arturvc/ROOK/ROOK_CAD/README.md

### ROOK
#### PLAYFUL DATA VISUALIZATION FOR AIR QUALITY

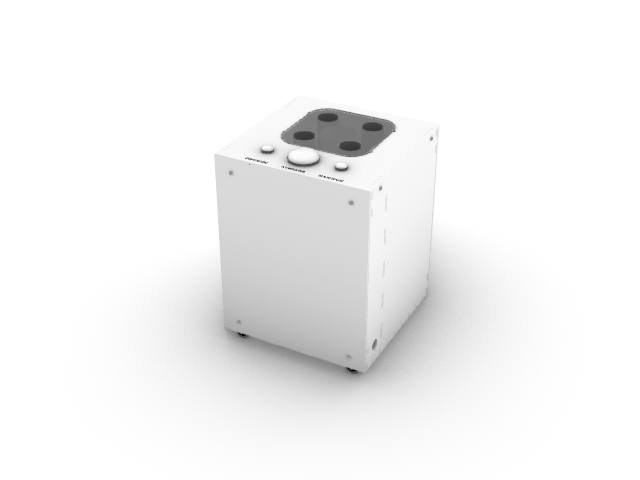
[picture p2: ROOK_CAD/Rook.png]
Rook


CAD file with the design of Rook, for laser cutting plywood with 8mm thickness and clear acrylic with 2mm thickness.

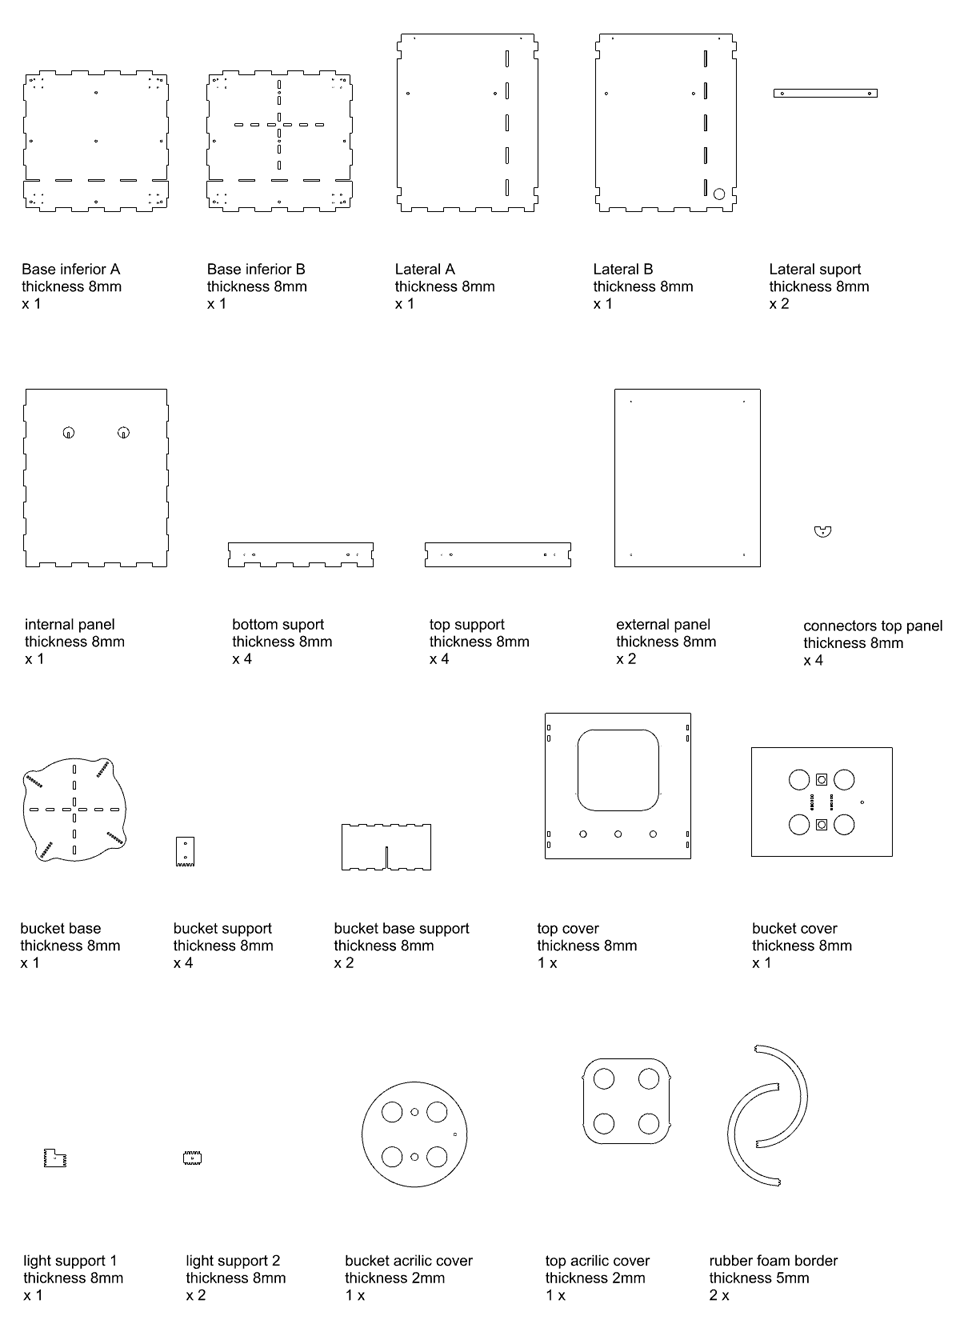
[picture p3: ROOK_CAD/Rook - parts - 960x1324.png]
Rook parts
