arturvc/ROOK/ROOK_CAD/Rook - iso 1.png

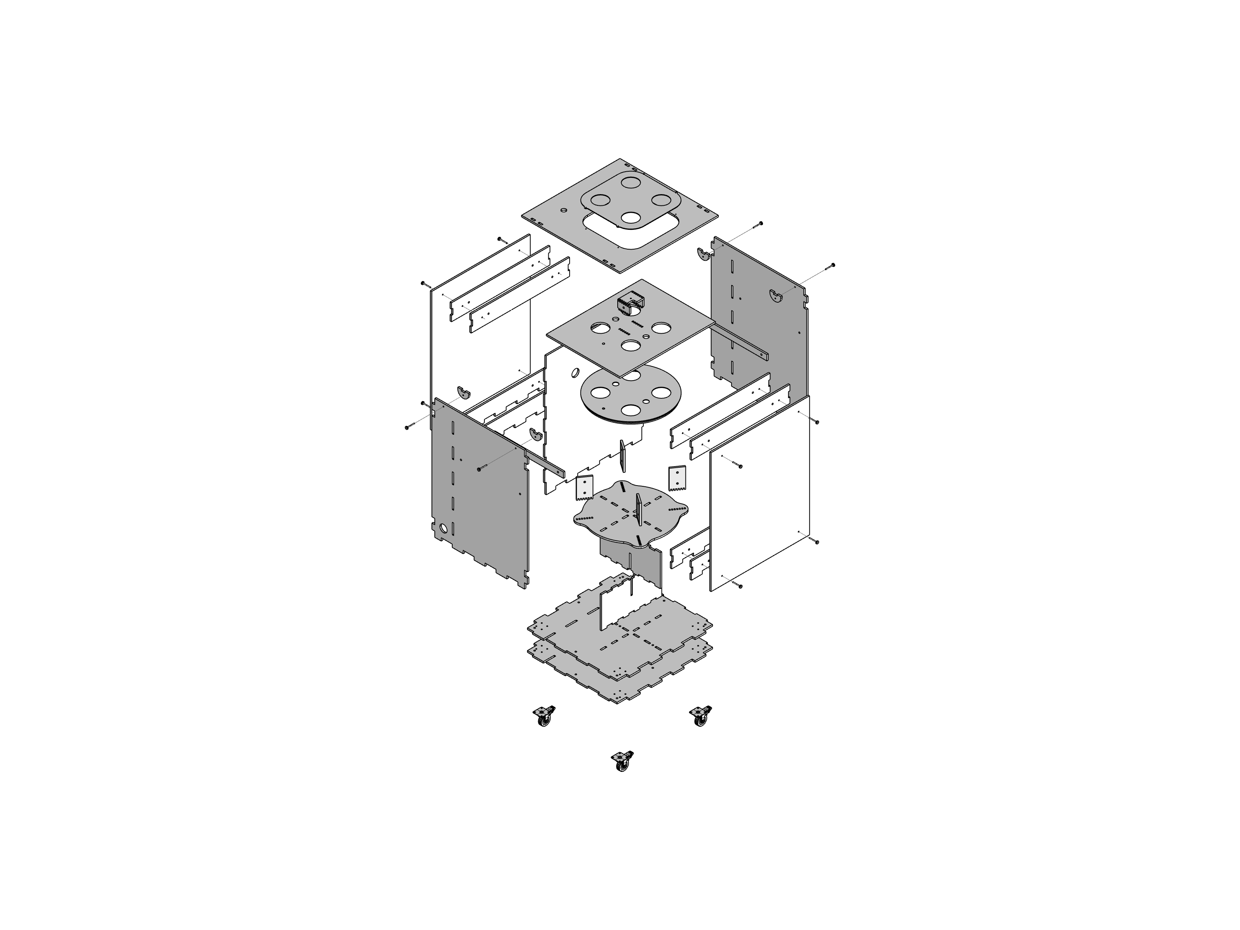
ROOK_CAD/Rook - iso 1.png
