arturvc/ROOK/ESP-Dmx-master/src/ESPDMX.cpp

// - - - - -
// ESPDMX - A Arduino library for sending and receiving DMX using the builtin serial hardware port.
// ESPDMX.cpp: Library implementation file
//
// Copyright (C) 2015  Rick <ricardogg95@gmail.com>
// This work is licensed under a GNU style license.
//
// Last change: Marcel Seerig <https://github.com/mseerig>
//
// Documentation and samples are available at https://github.com/Rickgg/ESP-Dmx
// - - - - -

/* ----- LIBRARIES ----- */
#include <Arduino.h>

#include "ESPDMX.h"



#define dmxMaxChannel  512
#define defaultMax 32

#define DMXSPEED       250000
#define DMXFORMAT      SERIAL_8N2
#define BREAKSPEED     83333
#define BREAKFORMAT    SERIAL_8N1

bool dmxStarted = false;
int sendPin;		
//int sendPin = 2;		//default on ESP8266
//int sendPin = 10;		//default on DOIT ESP32 DEVKIT


//DMX value array and size. Entry 0 will hold startbyte
uint8_t dmxData[dmxMaxChannel] = {};
int chanSize;


void DMXESPSerial::init(int pinNumber) {
  chanSize = defaultMax;
  sendPin = pinNumber;
  Serial1.begin(DMXSPEED);
  pinMode(sendPin, OUTPUT);
  dmxStarted = true;
}

// Set up the DMX-Protocol
void DMXESPSerial::init(int pinNumber, int chanQuant) {

  if (chanQuant > dmxMaxChannel || chanQuant <= 0) {
    chanQuant = defaultMax;
  }

  sendPin = pinNumber;
  chanSize = chanQuant;
  Serial1.begin(DMXSPEED);
  pinMode(sendPin, OUTPUT);
  dmxStarted = true;
}

// Function to read DMX data
uint8_t DMXESPSerial::read(int Channel) {
  if (dmxStarted == false) init(sendPin);

  if (Channel < 1) Channel = 1;
  if (Channel > dmxMaxChannel) Channel = dmxMaxChannel;
  return(dmxData[Channel]);
}

// Function to send DMX data
void DMXESPSerial::write(int Channel, uint8_t value) {
  if (dmxStarted == false) init(sendPin);

  if (Channel < 1) Channel = 1;
  if (Channel > chanSize) Channel = chanSize;
  if (value < 0) value = 0;
  if (value > 255) value = 255;

  dmxData[Channel] = value;
}

void DMXESPSerial::end() {
  delete dmxData;
  chanSize = 0;
  Serial1.end();
  dmxStarted == false;
}

void DMXESPSerial::update() {
  if (dmxStarted == false) init(sendPin);

  //Send break
  digitalWrite(sendPin, HIGH);
  Serial1.begin(BREAKSPEED, BREAKFORMAT);
  Serial1.write(0);
  Serial1.flush();
  delay(1);
  Serial1.end();

  //send data
  Serial1.begin(DMXSPEED, DMXFORMAT);
  digitalWrite(sendPin, LOW);
  Serial1.write(dmxData, chanSize);
  Serial1.flush();
  delay(1);
  Serial1.end();
}

// Function to update the DMX bus
