arturvc/ROOK/(commit log)

2019-11-07 The ESP32 code file for Rook
2019-11-07 The ESP-DMX Library
    In this code we use a modified version of the ESP-DMX library - Copyright (C) 2015 Rick <ricardogg95@gmail.com>
    The original library is for the ESP8266, and Luis Rodil-Fernandez modified it, so we can use it with ESP32.
    For more information of the original library, visit https://github.com/Rickgg/ESP-Dmx
2019-11-08 CAD file
    File with the cad design of Rook for laser cutting
